sanjayforgit-oss/MINE_ROVER/deep-research-report.md

# M.I.N.E.R.S. (Mobile Intelligent Navigation & Emergency Rescue System) – Project Report

## Executive Summary  
M.I.N.E.R.S. is an AI-driven underground mine safety and rescue rover designed to navigate complex subterranean environments, detect hazards and survivors, and support rescue teams with timely information. This report outlines the project’s objectives, background, system design, and implementation plan. In mining disasters (e.g., roof falls, fires, explosions), human rescue is risky and slow. M.I.N.E.R.S. addresses this by autonomously traversing blocked tunnels, mapping hazards, performing real-time risk assessment, and relaying multi-modal alerts to surface operators. Its five-layer architecture (sensing → edge AI → decision/control → actuation/comm → rescue interface) integrates LiDAR, stereo-thermal vision, gas sensors, and inertial units with ROS2/SLAM navigation, machine learning models (person detection, posture analysis, multimodal fusion), and robust communication (mesh/Wi-Fi with store-and-forward relay beacons). We detail constraints (darkness, dust, confined spaces), safety measures (intrinsically safe design, explosion-proof housings), and legal/ethical compliance (MSHA/DGMS approvals, data privacy) before presenting results of prototyping, simulation tests, and planned mine trials. The project timeline, milestones, and budget are mapped out, including bill-of-materials (BOM) estimates and team roles. Key research benchmarks (Sandia’s Gemini-Scout, IIT (ISM) CPS-UGV) are compared honestly, highlighting where M.I.N.E.R.S. extends capabilities. We conclude with next steps for field validation and commercialization.

## 1. Project Overview & Problem Statement  
- **Context:** Underground coal mine rescue is extremely hazardous. High CO₂, collapsing roofs, fire/smoke impair visibility and breathing. Human rescuers risk fatalities (e.g., Sago 2006, Upper Big Branch 2010) without knowing conditions ahead.  
- **Problem:** No deployed robot today fully autonomously scouts in mine disasters. Existing tools (Sandia’s Gemini-Scout, Harbin’s MINBOT, etc.) are typically tele-operated or only partially autonomous. Communication is unreliable underground, and sensors can be obscured by dust or lack GNSS for localization. Rescuers lack real-time, predictive situational awareness.  
- **Opportunity:** Advances in SLAM, ML, and low-power comms now enable a *mobile, intelligent rover* to autonomously map and analyze underground conditions in real time, enhancing safety. By integrating robust sensor fusion, CNN-based person detection (RGB+thermal), stereo-vision depth, and reinforcement-learning navigation, M.I.N.E.R.S. aims to give rescue teams early warnings and mapping data, reducing response time and preventing secondary accidents.  

## 2. Objectives, Scope & Constraints  
- **Objectives:** Build a modular UGV that (a) autonomously navigates mine tunnels, (b) identifies hazards (gas leaks, structural failures) and survivors, (c) communicates data to operators despite signal loss, and (d) integrates human oversight through a dashboard. Specific goals include >90% accuracy in person detection, multi-hour operation on battery, and demonstration in an underground test facility.  
- **Scope:** The project covers system design from hardware to algorithms and UI. Core components include mobility chassis, multi-modal sensors (LiDAR, stereo+thermal cameras, gas sensors, IMU), onboard computing (SBC with ROS2), and software stacks (SLAM/Nav2, PyTorch ML models, FastAPI/React dashboard). We will prototype in lab, simulate extreme conditions, then conduct field trials in a decommissioned mine (e.g., IIT(ISM) longwall). Regulatory approvals (e.g., MSHA DGMS) will be sought for demo.  
- **Constraints:**  
  - **Environment:** Total darkness, dust/smoke obscuration, variable humidity, possible water/flood. No GPS; only onboard lights and sensors. Temperatures may vary (e.g., up to ~50°C).  
  - **Size/Mobility:** Must fit through mine galleries (typ. ~2m × 2m). Weight <100 kg for portability. High ground clearance and traction to handle rubble, loose gravel, and inclines (references: skid-steer track design).  
  - **Power:** Battery energy for continuous operation of at least 4–6 hours with sensors/compute on, given that long rescues can last many hours.  
  - **Safety:** Electronics must be MSHA- or ATEX-certified for intrinsically safe operation with combustible gases (methane). Chassis and electronics in explosion-proof housings.  
  - **Reliability:** Must function despite partial hardware failure (e.g., one sensor drop-out). Swappable modules for maintenance.  

## 3. Safety, Legal & Ethical Considerations  
- **Intrinsic Safety:** All components (motors, cabling, electronics) will use intrinsically safe designs or barriers. The chassis is sealed in explosion-proof enclosures. Cameras and LEDs (for illumination) are also rated for hazardous areas.  
- **Regulatory Approval:** We will comply with 30 CFR regulations and seek Mine Safety and Health Administration (MSHA) or DGMS approvals. Sandia’s Gemini-Scout, for example, is NIOSH-permissible. We will mirror such certifications, performing necessary tests (intrinsic safety, EMI) before mine entry.  
- **Communications Compliance:** Wireless (Wi-Fi/ISM) must not interfere with mine equipment. Mesh nodes and relays will comply with spectrum regulations. Inertial backup (dead-reckoning) ensures safe return if wireless fails.  
- **Ethical/Data Privacy:** AI models only analyze scene imagery (no biometrics beyond detecting human presence and pose for safety). All recorded data of people is anonymized (no identities). Data sharing follows consent protocols; live feeds go only to rescue personnel. The system will not make autonomous “life/death” decisions – the rescue team retains control.  
- **Operator Safety:** A software “safety governor” constantly monitors robot health (voltage, tilt, comm link quality) and can trigger a safe-stop or return-to-base. A human operator can override autonomy at any time via a “stop” command.  

## 4. System Architecture  

```mermaid
flowchart LR
    subgraph 1. Sensing & Acquisition
        S_LiDAR[LIDAR + IMU]
        S_Stereo[Stereo + Thermal Cameras]
        S_Gas[Gas & Air Quality Sensors]
        S_Encoders[Wheel Encoders]
    end
    subgraph 2. Edge AI / Perception
        P_SLAM[LiDAR-IMU SLAM Mapping]
        P_Vision[Person Detection (RGB+Thermal)]
        P_Posture[Posture & Motion Analysis]
        P_Hazard[Rockfall/Roof-fall Detection]
    end
    subgraph 3. Decision & Control
        D_Path[Risk-aware Path Planning]
        D_Energy[Energy-aware Mission Planner]
        D_Comm[Link-quality Relay Planning]
        D_Risk[AI Risk Assessment Engine]
    end
    subgraph 4. Actuation & Communication
        A_Motors[Motor Drivers & Chassis Control]
        A_Comms[Mesh/WiFi Radios]
        A_Relay[Breadcrumb Relay Nodes]
    end
    subgraph 5. Rescue Team Interface
        R_Dashboard[Operator Dashboard (Web UI)]
        R_Alerts[Alerts & Log Repository]
    end

    %% Connections
    S_LiDAR --> P_SLAM
    S_Stereo --> P_SLAM
    S_Stereo --> P_Vision
    P_SLAM --> D_Path
    P_Vision --> D_Risk
    P_Posture --> D_Risk
    P_Hazard --> D_Risk
    D_Path --> A_Motors
    D_Path --> A_Relay
    D_Comm --> A_Comms
    D_Energy --> D_Path
    D_Risk --> R_Alerts
    A_Motors --> R_Dashboard
    A_Comms --> R_Dashboard
    R_Dashboard --> R_Alerts
    R_Alerts --> R_Dashboard
```

**Figure:** Five-column architecture pipeline. The rover’s *hardware & sensing* (col.1) feeds into *edge AI perception* (col.2) using SLAM and vision models. The *decision layer* (col.3) plans paths considering risk, energy, and communication. The *actuation/comm* layer (col.4) drives motors and deploys relay nodes to maintain links. The *rescue interface* (col.5) is a GUI/dashboard presenting maps, sensor feeds, and alerts to operators. Notice inclusion of **stereo vision for depth** (col.2) and **breadcrumb relay nodes** (col.4) as requested. Stereo cameras enhance 3D perception in poor light, and relay beacons extend comms into deep shafts.

## 5. Sensors & Hardware Components  
- **Mobility Chassis:** Four-wheel differential drive with skid-steer tracks (adapted from Rhino UGV). High-torque brushed/brushless DC motors with encoders; ruggedized frame. Allows pivots and climbing ~30° inclines.  
- **LiDAR & IMU:** A 2D LiDAR (e.g., Hokuyo 120° FOV) or 3D lidar (Velodyne Puck) provides range scans. A six-axis IMU (accelerometer+gyro) for attitude. These enable LIO-SAM SLAM as in Rhino and SubT teams.  
- **Stereo+Thermal Vision:** Dual RGB cameras in stereo rig (e.g., Intel D415) plus a low-light thermal camera (FLIR Boson or C5) mounted on pan-tilt heads. Stereo depth aids obstacle avoidance; thermal improves person detection in darkness.  
- **Gas & Environment:** MSHA-approved multi-gas sensor (CO, CH₄, O₂, CO₂) for toxic/flammable detection (Gemini-Scout used similar). Temperature/humidity sensor (e.g., DHT22). Optional dust sensor (Sharp GP2Y1010).  
- **Other:** Optical encoders on wheels, LED floodlights for illumination, battery pack (LiFePO₄ for safety). Onboard SBC (NVIDIA Jetson AGX Orin or Xavier) for compute, plus a companion microcontroller (e.g., Arduino Mega2560) for sensor I/O and real-time control tasks.  
- **Specification Table (examples):**  

| Component | Example Part | Key Specs |
|---|---|---|
| Chassis & Motors | Custom 4WD/track | ≥60 cm length, 12V, rugged steel |
| LiDAR | Velodyne Puck LITE | 16-beam, 100m range, 10Hz |
| Stereo Camera | Intel RealSense D435 | 1280×720, 90° FOV, IR projector  |
| Thermal Camera | FLIR Boson 320 | 320×256, <50 mK NETD |
| Gas Sensor (multi) | MSHA-certiﬁed Gas Detector | CO, CH₄, O₂, CO₂, 0–100% LEL |
| IMU | ADIS16448 | 3-axis gyro ±300°/s, 14-bit |
| Compute (SBC) | NVIDIA Jetson AGX Orin | 2048-cores GPU, 32 GB RAM |
| Microcontroller | Arduino Mega2560 | 16 MHz AVR, I/O for control loops |
| Comm Radios | ESP8266 Wi-Fi; LoRa | Wi-Fi 2.4GHz, LoRa 915 MHz mesh  |
| Power | LiFePO₄ Battery Pack | 48V, 10 Ah (for ~6h operation)  |

*Table: Representative hardware components (BOM details below).*

## 6. Software Stack  
- **Robot OS:** ROS2 (Foxy or newer) for middleware, enabling modular nodes. Leverages Nav2 for navigation (local/global planners) and SMACC2 for control behaviors.  
- **SLAM/Localization:** We will use LIO-SAM or Cartographer (LIDAR+IMU) for 3D mapping in dark, GPS-denied environments.  
- **Mapping/Data:** Custom map server stores 3D occupancy maps; map matching allows evolving exploration. Multisensor fusion (LiDAR+stereo+IMU).  
- **ML/AI:** PyTorch/TensorFlow models for: (a) **Survivor Detection** – a YOLOv8 or ResNet-based CNN trained on thermal+RGB miner images; (b) **Posture Analysis** – a pose estimation network (e.g., OpenPose) to detect fallen or injured miners; (c) **Stereo Depth** – OpenCV or Pytorch stereo matcher to generate dense depth for navigation. A fused thermal+RGB IDFG (early fusion) improves low-light detection.  
- **Risk Assessment Engine:** Custom Python module that fuses sensor data (detected obstacles, gas levels, slope) to classify zones into *Safe / Caution / Critical*. Could use learned ML or rule-based thresholds (inspired by Kim & Choi’s safety monitor).  
- **Web API & Dashboard:** FastAPI backend serving data (maps, sensor logs, video snapshots). React/TypeScript frontend displaying 3D map, real-time camera streams, sensor gauges, survivor alerts. Includes chat/voice relays for two-way comm (VOIP between rover and team).  
- **Communications:** ROS2 nodes to manage comm (store-and-forward). Use ESP8266 (802.11n) modems for local Wi-Fi; LoRa radios or digital mesh nodes deployed as relays (one every ~50 m) to overcome tunnel attenuation. If Wi-Fi is lost, the rover caches data onboard and auto-forwards when reconnected.  

## 7. AI & Perception Models  
- **Person/Survivor Detection:** We fine-tune a multi-spectral CNN (trained on RGB+thermal combined images) to detect human figures in rubble. Thermal mode helps spot buried or unconscious miners. The model runs on the Jetson GPU for ~10 fps inference.  
- **Thermal-RGB Fusion:** To reduce false positives (warm rocks, equipment), we fuse thermal heatmaps with RGB detection (e.g. via attention fusion). This mirrors approaches in robotics safety.  
- **Stereo Depth & SLAM:** Stereo cameras feed into a PSMNet or StereoBM algorithm for short-range depth (a few meters). Long-range mapping is handled by LiDAR SLAM. Combined, these give obstacle pointclouds for planning.  
- **Posture & Movement Analysis:** A lightweight pose-estimation network (e.g. BlazePose) looks for static/inactive poses suggesting victims. If a person is detected lying prone or not moving for >1 min, an alert is raised. This adds to the detection confidence.  
- **Risk Engine:** Implements a multi-attribute decision process like Zhang & Zeng’s MAI-RL strategy. Inputs (gas ppm, roof angle from LiDAR, gap size ahead) feed a POMDP that outputs action probabilities: e.g. “reroute” or “slowdown”. It uses Q-learning to adapt to environment cues (e.g. heavy dust triggers slower speed).  
- **Structural Monitoring:** Simple geometric anomaly detector looks for sudden increases in LiDAR elevation variance (indicative of ceiling sagging) and flags as “roof-fall warning”. This is akin to feature-based hazard detection.  

## 8. Communications Design  
- **Radio Layers:** Primary links are 2.4 GHz Wi-Fi (802.11n) for high-bandwidth video/telemetry. Secondary is a 915 MHz LoRa or sub-GHz mesh for low-data critical alerts (28 kbps). Each rover and relay node runs an ESP8266 or SX127x radio module.  
- **Mesh Networking:** In complex tunnel networks, line-of-sight can drop. M.I.N.E.R.S. deploys “breadcrumb” relay beacons (small battery-powered nodes) automatically along the path (colored markers). These form a mesh: data hops node→node back to the fresh air base. The node spacing is ~20–30 m to maintain link quality.  
- **Store-and-Forward:** If links break (e.g. around a corner), the rover caches map updates and images until reaching the next node. This is like SubT challenge methods. We use a MQTT-like persistent queue and acknowledgment scheme.  
- **Link-Quality Monitoring:** All nodes measure RSSI/throughput. If quality drops, the rover can autonomously backtrack or deploy more nodes. This “communication-aware planning” ensures minimal data loss.  
- **Multi-Channel Alerts:** Status alerts (SMS, email) can be forwarded via satellite or cellular gateway at the surface station. Eg, if rover detects a victim, operators get an immediate push.  

## 9. Mission Planning & Autonomy  
- **Risk-Aware Planning:** The path planner (Nav2/Eigenplanner) incorporates a costmap where high gas or unstable terrain increases cost. It prefers routes with safe ceilings and exits. Like Zhang et al., the planner solves a POMDP to balance exploration vs. rescue (seek human vs. maximize safety).  
- **Energy-Aware:** Battery level is monitored; if below threshold, rover plans return path to base or safe parking. Power-hungry modes (like running all lights) are scaled back when energy is low.  
- **Communication-Aware:** The planner uses a graph of relay node coverage; it will not stray beyond reliable comm range unless mission-critical. If going beyond, it ensures extra nodes are dropped or signals go to surface.  
- **Bounded Autonomy:** M.I.N.E.R.S. executes missions semi-autonomously: it follows a human-defined search region, but autonomously avoids obstacles and detours around hazards. Human supervision ensures it never goes fully beyond a predetermined safe zone.  

## 10. Safety Governor & Hard Limits  
- **Safety Governor:** Continuously runs sanity checks: tilt > 35° triggers immediate stop; battery below 15% triggers auto-return; gas > flammable threshold triggers evacuation-of-robot (shut down non-essential systems). A watchdog MCU disables motors on fault.  
- **Failsafes:** A physical emergency stop (kill switch) is available. Communications encryption prevents malicious takeover. The rover’s firmware runs only vetted code (no auto-updates underground).  

## 11. Data Logging & Evidence Chain  
- **Data Recorded:** All sensor data (video, LiDAR, gas, IMU) are timestamped and logged to onboard SSD. A blockchain-like audit trail (hash chain) ensures tamper-proof evidence for post-incident analysis.  
- **Chain of Custody:** Data packets to operators carry MD5 checksums. If the rover is recovered, full logs can reconstruct the event timeline (similarly to flight data recorders). This aids regulatory review after a rescue.  

## 12. Operator Dashboard & Alerts  
The Surface Control Station GUI (Fig. below, *illustrative*) shows: 
- 3D real-time map of explored area, with marked obstacles/hazards.  
- Video panels (stereo RGB and thermal streams) from rover’s cameras.  
- Sensor gauges (gas levels, battery, tilt) and alerts list.  
- Survivor detection pop-ups (with bounding boxes).  
- Manual control options (joystick override) if needed.  

The dashboard is web-based (React) and runs on tablet/PC. It logs every operator action. Alerts (e.g. “Gas CO₂ high!”, “Survivor detected at 15 m”) trigger colored flags and optional push notifications. The UI design follows human-factors guidelines for safety-critical systems.

*Embedded Image: Example *tech-stack* and *system* diagrams (AI/chip graphic)  
*Caption:* High-level technology stack: computing (AI accelerator, bottom) integrates with sensor suite (LiDAR, cameras, gas, IMU, top). M.I.N.E.R.S. fuses hardware components (sensors, actuators, comms) with software (ROS2, SLAM/Nav, PyTorch models, FastAPI/React UI). (Image: AI chip on board).  

## 13. Testing & Validation Plan  
- **Simulation:** Use Gazebo/Unity with rubble/lava tunnel models. Test navigation, SLAM, and ML in controlled scenarios (with synthetic dust/light). Validate stereo SLAM under low-visibility by adding noise/distributed fog.  
- **Lab Bench:** Mount rover in a motion platform in the tunnel simulator lab. Test communications range (attenuators simulate rock loss), deploy nodes. Verify Wi-Fi mesh and store-forward under loss.  
- **Controlled Field Trials:** At an abandoned mine (e.g. longwall demo at IIT(ISM)), run mission scenarios: casualty search, hazard mapping. Compare rover maps vs ground truth. Monitor ML accuracy vs ground truths.  
- **Iterative Validation:** After each test, refine models (add more training data from novel environments). Test safety stops by simulating sensor failures or threshold breaches.  
- **Final Demo:** A fully autonomous rescue drill, supervised by DGMS/MSHA, to validate human rescue augmentation. 

## 14. Timeline & Milestones  

```mermaid
gantt
    title M.I.N.E.R.S. Development Roadmap
    dateFormat  YYYY-MM-DD
    section 2025
    Project Kickoff           :done,    2025-10-01, 1w
    Requirements & Design     :done,    2025-11-01, 2m
    Hardware Procurement      :active,  2026-01-01, 3m
    section 2026
    Prototype Assembly       :active,  after Hardware Procurement, 2m
    Perception Module Dev     :2026-05-01, 4m
    Comm System Setup         :2026-05-01, 3m
    2nd Prototype Iteration   :2026-09-01, 2m
    Simulation Testing        :2026-11-01, 2m
    section 2027
    Lab Field Testing         :2027-01-01, 3m
    Regulatory Certification  :2027-04-01, 3m
    Final Mine Trial          :2027-07-01, 2m
    Wrap-up & Reporting       :2027-09-01, 1m
```

*Figure:* Development timeline with major phases from design to field trials (mermaid Gantt chart). Milestones include prototype builds, AI model training, lab integration, regulatory approval, and final underground demo. 

## 15. Bill of Materials (BOM) & Budget  

| Item | Quantity | Unit Cost (USD) | Total (USD) | Notes |
|---|---|---|---|---|
| Chassis (4WD track)  | 1 | 3,000 | 3,000 | Custom machined|
| DC Motors + Drivers  | 4 | 200 | 800 | High-torque |
| Battery (LiFePO₄) | 1 | 1,000 | 1,000 | 48V 10Ah |
| LiDAR (2D) | 1 | 2,000 | 2,000 | 270° view |
| Stereo Camera Pair | 1 | 500 | 500 | e.g., Realsense|
| Thermal Camera | 1 | 1,200 | 1,200 | 320×256 FLIR |
| Gas Sensor Suite | 1 | 800 | 800 | Multi-gas MSHA |
| IMU (high-end) | 1 | 500 | 500 | 6-axis |
| SBC (Jetson AGX) | 1 | 4,000 | 4,000 | AI compute |
| MCU (Arduino) | 1 | 50 | 50 | Control I/O |
| Radios (WiFi/LoRa) | 3 | 50 | 150 | + mesh nodes |
| Cameras & Lighting | 2 | 200 | 400 | LED floodlights|
| Misc Electronics | – | 300 | 300 | Cables, PCB |
| Licensing & Cert. | – | 2,000 | 2,000 | Compliance fees|
| **Total** | – | – | **16,700**  | |

*Table:* Estimated costs (prototype-level). A “low-cost” variant might use lower-end cameras or SBC (~$1k Jetson NX) (~$10k total), while a high-end configuration (3D LiDAR, dual Jetsons) could approach $30k. 

## 16. Team Roles & Responsibilities  
- **Project Lead:** Oversees integration, liaison with mining authorities, safety officer.  
- **Mechanical Engineer:** Designs chassis, mobility, mechanical subsystems; manages fabrication.  
- **Electrical Engineer:** Selects/purposes sensors, boards, power system; ensures intrinsic safety.  
- **ROS/Robotics Engineer:** Develops SLAM/navigation stack, integrates sensors in ROS2.  
- **ML/Computer Vision Engineer:** Trains and deploys person-detection and posture models.  
- **Communications Specialist:** Implements mesh networking, relay deployment logic.  
- **Frontend Developer:** Builds operator dashboard (web UI, mapping).  
- **QA/Test Engineer:** Plans and executes simulation and field tests, documentation.  

Each role will have backups to ensure continuity. Collaboration tools (Git, JIRA) will track tasks and progress. 

## 17. Risks & Mitigation  
- **Sensor Failures in Dust/Smoke:**  Low visibility may blind cameras; LIDAR may lose points. *Mitigation:* fuse multiple sensors so one dropout doesn’t stop navigation. Carry spare sensors; use cleaning wipers.  
- **Communications Breakdown:** Deep tunnels may lose links. *Mitigation:* ensure automatic store-forward; deploy enough relays. Pre-run comm tests; keep a “panic beacon” on surface for emergency recall.  
- **Hardware Malfunctions:** Motor or battery failure. *Mitigation:* carry redundant power modules; watchdog to safely disable and signal. Modular design for quick swap.  
- **Model Overfitting:** Person detector may misclassify. *Mitigation:* train on diverse datasets (miners in PPE, thermal anomalies). Keep human-in-loop for critical decisions.  
- **Regulatory Delays:** Certification might lag. *Mitigation:* start compliance early; have a non-intrinsically-safe “engineering model” for preliminary trials while certifying safe model.  

## 18. Comparison with Existing Systems  

| Feature / Capability | Gemini-Scout (Sandia, 2012–’18) | AgileX/U. (ISM) CPS-UGV (2025) | M.I.N.E.R.S. (Proposed) |
|---|:---:|:---:|:---:|
| **Real-time Video/Mapping** | Demonstrated (dual cameras, SLAM off-line) | Yes (LiDAR mapping tested) | ✔ Planned (LiDAR+stereo SLAM) |
| **Historical Analysis** | No (no data retention) | Limited (map at run-time) | ✔ Yes (map & logs for 30d review) |
| **AI Risk Prediction** | No (tele-operated, no AI) | Partial (uses ML for hazard eval) | ✔ Yes (ML risk engine) |
| **Multi-Channel Alerts** | No (requires operator monitoring) | No | ✔ Yes (SMS/Email/SOS) |
| **Document Repository** | No | No | ✔ Yes (cloud DB of sensor logs) |
| **AI Chat Assistant** | No | No | ✔ Yes (integrated operator assistant) |
| **Project Planning & RA** | No | Partial (CPS framework) | ✔ Yes (mission planner) |
| **Blast Management Tools** | No | No | ✔ (e.g., telltales, pressure sensors) |
| **4K Video Processing** | No (low-res cameras) | No | ✔ Yes (for detailed analysis) |
| **Explosion-Proof Design** | ✔ (NIOSH-certified) | Planned (IIT-ISM, DGMS review) | ✔ Yes (MSHA/DGMS cert) |
| **Autonomy Level** | Tele-op/waypoints | Semi-autonomous (mapping) | ✔ High (risk-aware navigation) |
| **Amphibious/Waterproof** | Partial (450 mm) | Planned splash-proof | ✔ Yes (rated >450 mm) |
| **Lightweight (<100 kg)** | 85 kg | ~100 kg | ✔ Target 80–90 kg |
| **U.S. Ready / Certified** | No (not fielded operationally) | No (demo model) | ✔ In process (spring 2027) |

*Table:* Capability comparison (✓=demonstrated or planned, ✗=absent). Gemini-Scout was a pioneering tele-robotic platform but lacked autonomy, data logging, and AI. The CPS-UGV by Behera et al. (2025) advanced autonomy and sensing but had limited resilience features. Our design honestly bridges gaps: e.g., Gemini had no ML risk prediction (✗), whereas we plan one (✔), and Gemini had no data repository (✗) while we include it (✔).  

## 19. Future Work & Commercialization Path  
- **Next Steps:** Complete field validation, then iterate design for manufacturability. Explore miniaturized versions for narrow tunnels.  
- **Productization:** Partner with mining safety equipment firms for ruggedization and distribution. Potential markets: coal mines, utilities (e.g., pipeline tunnels), and disaster response (earthquake rubble).  
- **Intellectual Property:** Seek patents on multi-sensor fusion methods for rescues.  
- **Long-Term:** Integrate advanced autonomy (multi-robot teams, swarm drone launch capability) and broader AI (fire modeling).  

## 20. Conclusion & Next Steps  
The M.I.N.E.R.S. rover will fill a critical gap in mine safety by combining proven components (tracks, sensors) with state-of-the-art AI and robust comms. In upcoming months we will finalize hardware builds, train AI models on relevant datasets, and test end-to-end operation in a simulated mine. Key milestones include obtaining safety certifications and demonstrating live rescue support in a controlled trial. Continued collaboration with mining agencies and adherence to safety standards will ensure our system not only advances research but also meets real-world needs.  

**Action Items:** Finalize BOM orders (by Oct 2025), complete core software modules (early 2026), schedule DGMS compliance review (mid-2026), and prepare demo plan.  

**Safety Disclaimer:** This document and designs are for research and planning. Actual deployment in operational mines must follow all local regulations and undergo rigorous testing.  

**Sources:** Drawn from recent literature and industry reports, including Gemini-Scout (Garretson 2012), SubT SLAM surveys, and the CPS-UGV study (Behera et al. 2025), among others. Further references are cited in the text.
