sanjayforgit-oss/MINE_ROVER/miners_architecture_human.pptx

SYSTEM ARCHITECTURE & TECHNICAL FLOW
M.I.N.E.R.S. — Mobile Intelligent Navigation and Emergency Rescue System | SIH 2026 (PS ID: 26039)

01. MULTI-MODAL SENSING
Environmental & Spatial Perception
• 360° 2D LiDAR: Continuous 2D tunnel mapping & boundary obstacle detection (No 3D LiDAR).
• Stereo RGB-D Camera: Unified camera for visual video stream & dense depth traversability.
• Thermal IR Camera: Detects survivor body heat signatures through darkness, dust and smoke.
• Multi-Gas Sensor Array: Real-time toxic & flammable gas tracking (CH4, CO, CO2, O2, Smoke).
• Slip-Aware IMU & Encoders: 6-DOF IMU and wheel encoders provide dead reckoning in zero-GPS tunnels.

02. INTELLIGENT EDGE BRAIN
Onboard AI & Distributed Compute
• Raspberry Pi 5 (8GB): Master edge host orchestrating ROS2 nodes, communication & sensor fusion.
• Raspberry Pi AI HAT+: 26 TOPS NPU delivers real-time on-device YOLOv8 person & posture inference.
• Arduino Mega 2560: Hard real-time deterministic motor PWM actuation & hardware safety watchdog.
• Isolated Power Unit: Dedicated 12V high-current motor rails & clean 5V logic rails with BMS telemetry.

03. BOUNDED AUTONOMY & SAFETY
Resilient Decision & Fail-Safe Navigation
• Safety Governor: Hard constraint rules strictly override AI to enforce emergency stops & safe retreat.
• Bounded Autonomy: Operates under strict distance & time limits during complete communication loss.
• Safe Auto-Rollback: Backtracks along proven safe path upon sudden gas spikes or structural cracks.
• Breadcrumb Mesh Relays: Drops deployable wireless repeater nodes to maintain connectivity deep inside.
• Blackbox SD Buffer: Store-and-forward local logging guarantees zero mission data is ever lost.

SURFACE RESCUE COMMAND STATION (Human-in-the-Loop Base)
🗺️ Real-Time 2D Grid & Gas Heatmap | 📹 Video + Thermal IR Stream | 📡 Mesh Relay Telemetry | 🕹️ Manual Emergency Override (E-STOP)
Guiding Principle: “AI Assists Detection — Rescue Team Makes the Final Decision” | Bounded Autonomy During Signal Blackout
