sanjayforgit-oss/MINE_ROVER/link_plate_120x8mm_preview.png

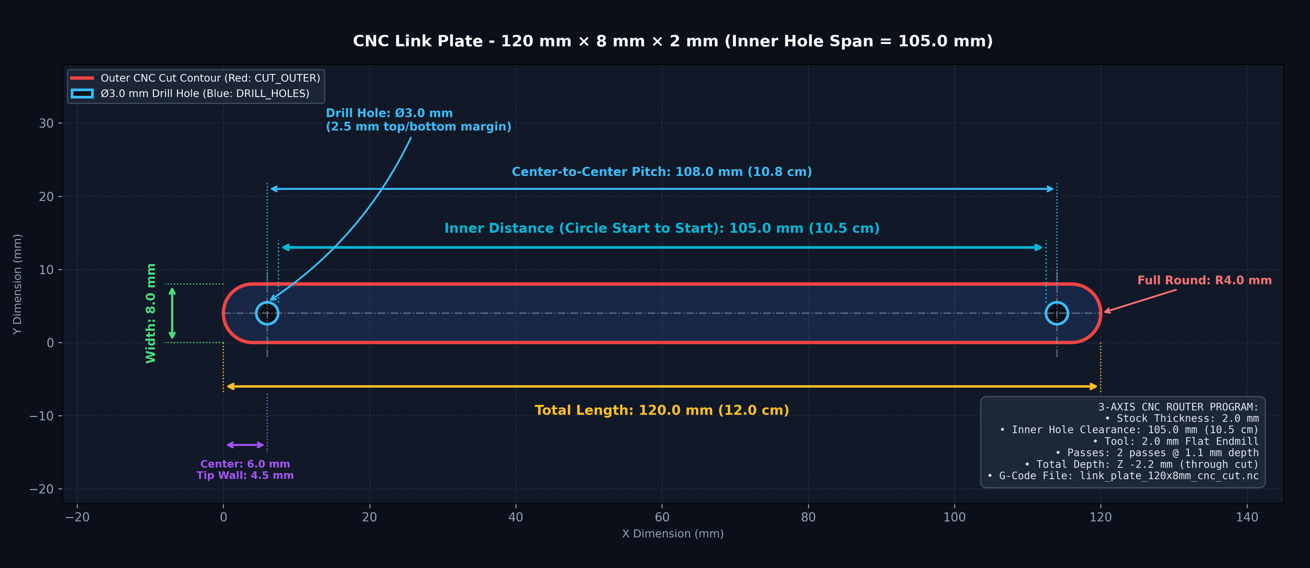
link_plate_120x8mm_preview.png
