sanjayforgit-oss/MINE_ROVER/rover_base_alternative_designs.png

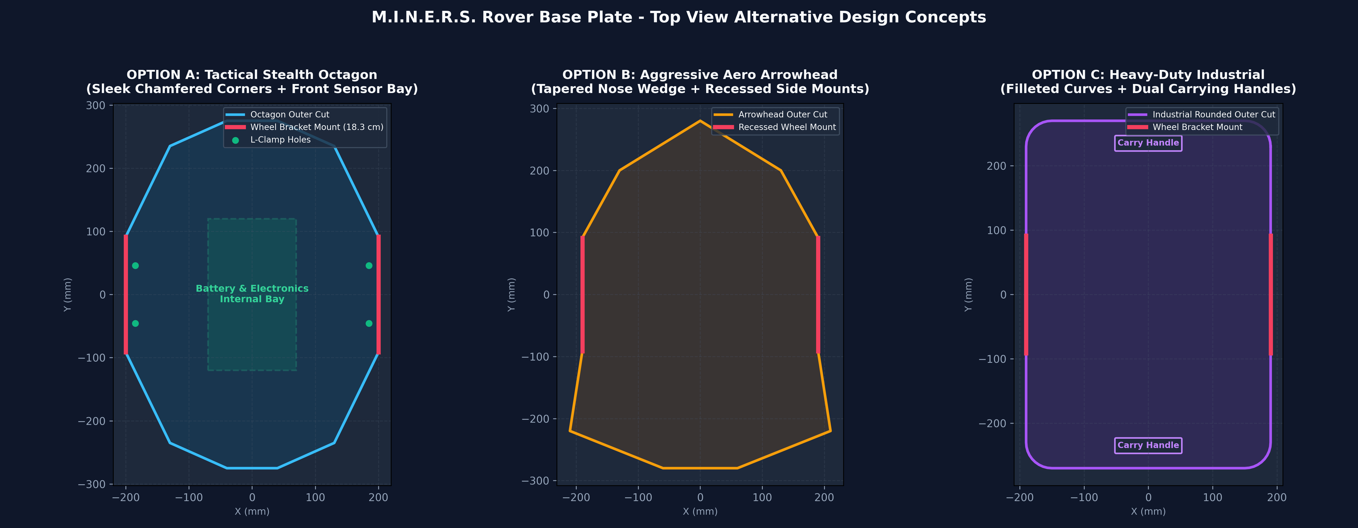
rover_base_alternative_designs.png
