sanjayforgit-oss/MINE_ROVER/rover_base_preview.png

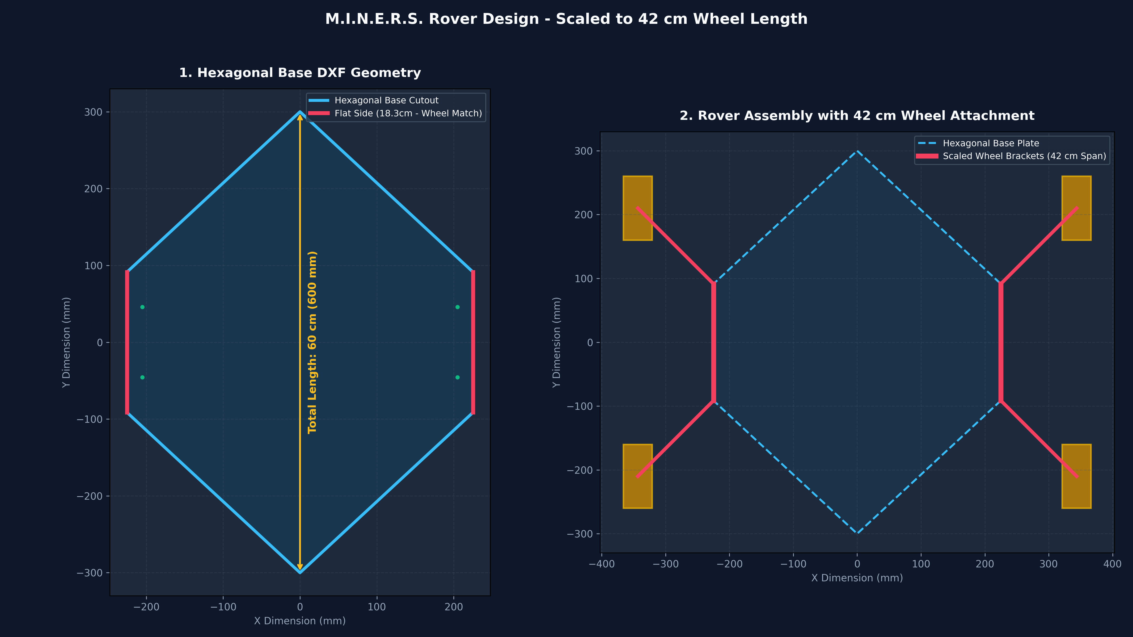
rover_base_preview.png
