sanjayforgit-oss/MINE_ROVER/simulation_video_preview.png

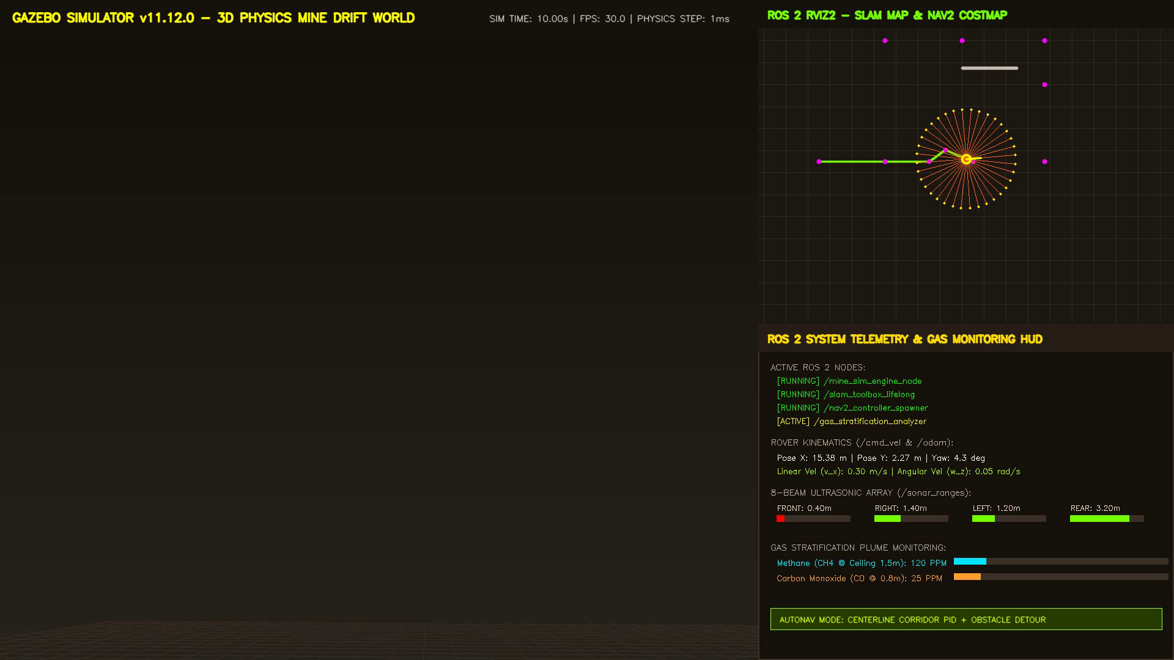
simulation_video_preview.png
