sanjayforgit-oss/MINE_ROVER/wheel_attachment_bracket_preview.png

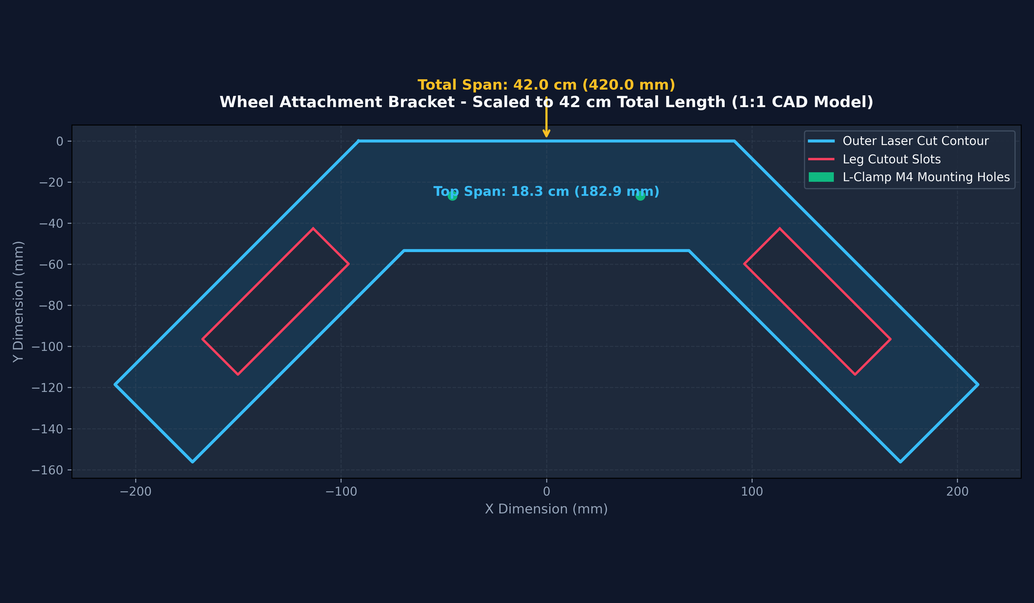
wheel_attachment_bracket_preview.png
