sanjayforgit-oss/MINE_ROVER/wheel_base_support_crossbar_preview.png

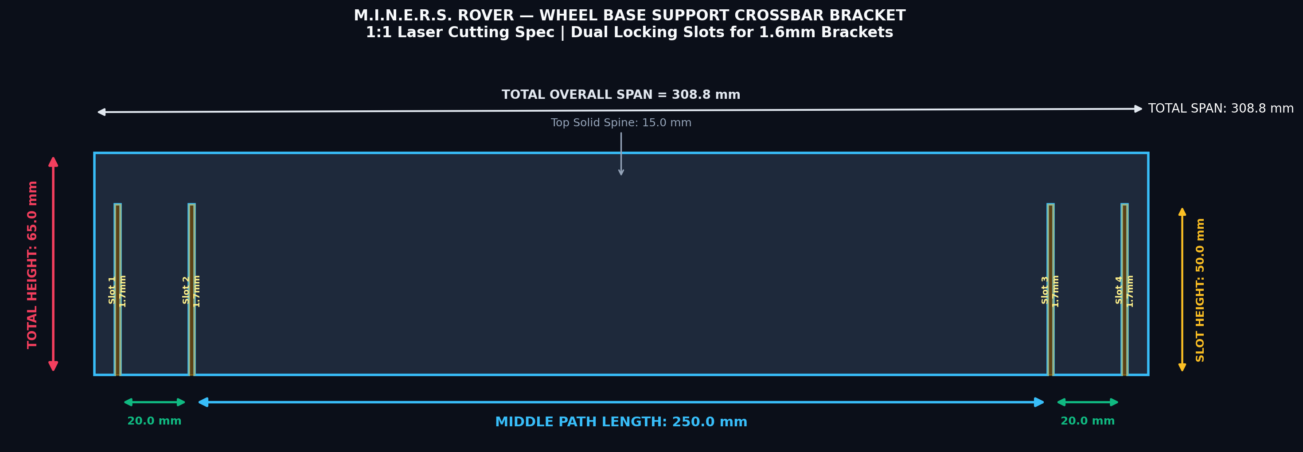
wheel_base_support_crossbar_preview.png
