sanjayforgit-oss/MINE_ROVER/wheel_bracket_spacer_clip_preview.png

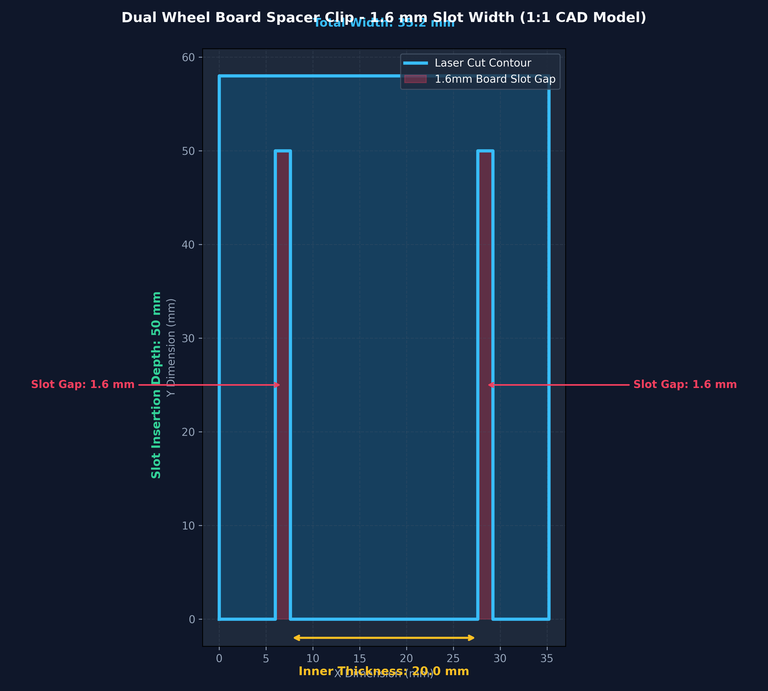
wheel_bracket_spacer_clip_preview.png
