sanjayforgit-oss/MINE_ROVER/component list of minerover.xlsx

Components list for MINEROVER |  |  |  |  |  |  | PDF item | Qty in your inventory | MINE-SENTINEL use
S.NO | NAME | count | 1pcs PRICE | total price | LINK | estimate | Arduino Mega 2560 16U2 clone | 10 | Low-level controller/safety I/O
1 | Raspberry pi 5 with 8gb ram | 1 | 23500 | 23500 | https://amzn.in/d/09Gowpl9 |  | SanDisk Ultra 32 GB microSD | 5 | Initial Pi storage
2 | Raspberry Pi AI HAT+ 26 TOPS | 1 | 15250 | 15250 | https://amzn.in/d/0adwNgWo |  | 12 V 150 RPM gear motor | 20 | 4WD prototype
3 | raspberry pi cooling fan | 1 | 1050 | 1050 | https://amzn.in/d/077CWEg8 |  | NodeMCU ESP8266 | 6 | Prototype communication/relay
4 | 360 degree 2d lidar | 1 | 6300 | 6300 | https://robu.in/product/ydlidar-x2l-range-finder/?gad_source=1&gad_campaignid=20363337560 |  | DHT-11 | 1940-10-01 | Initial temperature/humidity
5 | Waveshare IMX219-83 Stereo Camera | 1 | 6400 | 6400 | https://robu.in/product/waveshare-imx219-83-stereo-camera-8mp-binocular-camera-module-depth-vision/ |  | MQ-4 | 3 | Prototype methane-sensitive channel
6 | ASAIR AO-03 Oxygen Sensor Module | 1 | 1219 | 1219 | https://robu.in/product/oxygen-sensor-model-ao-03/ |  | MQ-7 | 3 | Prototype CO-sensitive channel
7 | Robocraze GP2Y1010AU0F Optical Dust Sensor | 1 | 660 | 660 | https://amzn.in/d/0bnvKIct |  | Ultrasonic SR04 | 40 | Close-range obstacle safety
8 | MAX9814 microphone module | 1 | 367 | 367 | https://amzn.in/d/03cLVMzK |  | Joystick module | 10 | Manual control mode
9 | 2pcs BTS7960 43A High Power Motor Driver | 2 | 1080 | 2160 | https://amzn.in/d/0hfzQLRg |  | Relay boards | 20 | Low-current auxiliary switching
10 | wheel encoder LM393 Optical Coupling Module pack of 5 | 1 | 299 | 299 | https://amzn.in/d/0b53gtjS |  | MG996/MG90/MG995 servos | 30 total variants | Camera/sensor actuation
11 | 20-sot encoder dics | 1 | 499 | 499 | https://amzn.in/d/05nODV82 |  | Jumper wires | Many | Prototype
12 | IMU (MPU6050 6- axis gyroscope and accelerometer | 1 | 319 | 319 | https://amzn.in/d/096DA06l |  | Hookup wire | Available | Prototype
13 | 12.8V 30Ah (384Wh) LiFePO4 | 1 | 7869 | 7869 | https://amzn.in/d/0eaNqDHC | 9000 | 0–30 V / 5 A bench supply | 1 | Laboratory development
14 | battery charger | 1 | 1449 | 1449 | https://amzn.in/d/05J6uaGG |  | Oscilloscope | 1 | Testing
15 | dc-dc buck converter | 1 | 587 | 587 | https://amzn.in/d/02MxcZ3Q |  | Soldering station | 2 | Assembly
16 | dc-dc step dpwn for raspberry | 1 | 490 | 490 | https://amzn.in/d/05kZcI8O
17 | dc-dc atep down for esp, mega | 1 | 494 | 494 | https://amzn.in/d/01jdCEdt
18 | fuse holder | 1 | 292 | 292 | https://amzn.in/d/0hhNiHZU
19 | main battery switch 12v - 24v | 1 | 399 | 399 | https://amzn.in/d/06YptNCs
20 | 12v , 80A automative relay | 1 | 199 | 199 | https://amzn.in/d/0ffsDL9Q
21 | power distributor | 1 | diy | 0
22 | xt60 connector pins | 1 | 155 | 155 | https://amzn.in/d/0gwMlcKR
23 | terminal lock/ferules |  | 0 | 0
24 | push button switch | 1 | 280 | 280 | https://amzn.in/d/0cO8GgRb
25 | INA219 - BATTERY POWER SENSOR | 1 | 209 | 209 | https://amzn.in/d/0hpKUrba
26 | main batter current sensor module | 1 | 672 | 672 | https://amzn.in/d/0aK1Whwd | cheaper here - https://thinkrobotics.com/products/acs758?variant=49842274369853&country=IN&currency=INR
27 | pan/tilt servo bracker, for camera moving | 1 | 240 | 240 | https://amzn.in/d/0i13CrOu
28 | water level sensor | 1 | 57 | 57 | https://amzn.in/d/0bLffNhl
29 | strip light(pack of 20)- used as head lights | 1 | 293 | 293 | https://amzn.in/d/014DVYJ4
30
 |  |  | TOTAL | 71708
