sanjayforgit-oss/MINE_ROVER/wheel_attachment_bracket.dxf

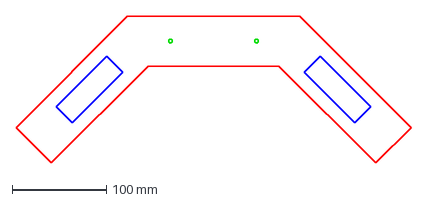
[picture p8: CAD file, 2026-10-26]
wheel_attachment_bracket.dxf
420.0 x 156.3 mm
