sanjayforgit-oss/MINE_ROVER/wheel_bracket_spacer_clip.dxf

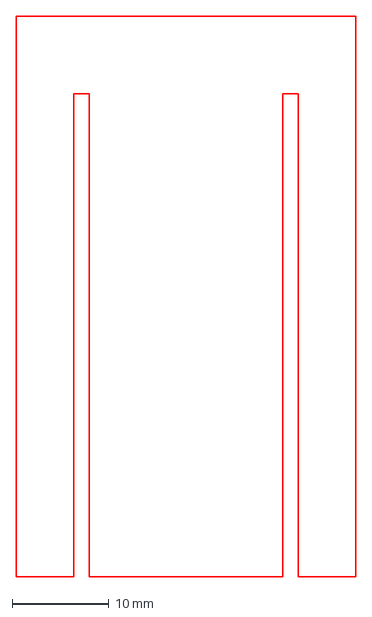
[picture p9: CAD file, 2026-10-26]
wheel_bracket_spacer_clip.dxf
35.2 x 58.0 mm
