sanjayforgit-oss/MINE_ROVER/link_plate_120x8mm_offset8mm.dxf

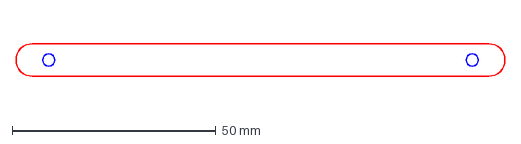
[picture p11: CAD file, 2026-10-26]
link_plate_120x8mm_offset8mm.dxf
120.0 x 8.00 mm
