sanjayforgit-oss/MINE_ROVER/wheel_base_support_crossbar.dxf

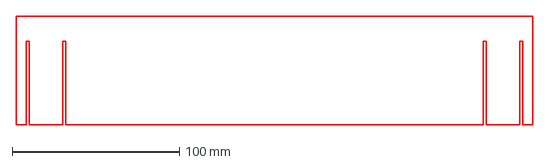
[picture p12: CAD file, 2026-10-26]
wheel_base_support_crossbar.dxf
308.8 x 65.0 mm
