sanjayforgit-oss/MINE_ROVER/sample_mine_drift_blueprint.dxf

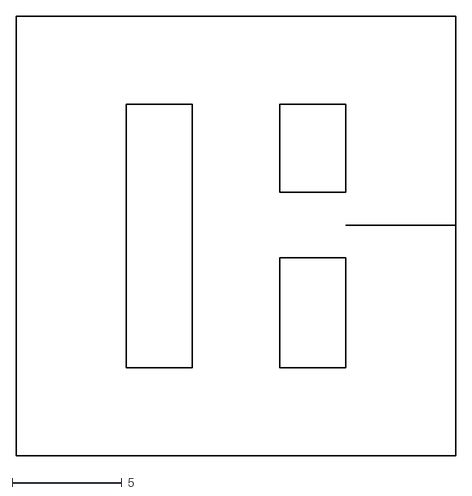
[picture p13: CAD file, 2026-10-26]
sample_mine_drift_blueprint.dxf
20.0 x 20.0
