sanjayforgit-oss/MINE_ROVER/rover_base_hexagon.dxf

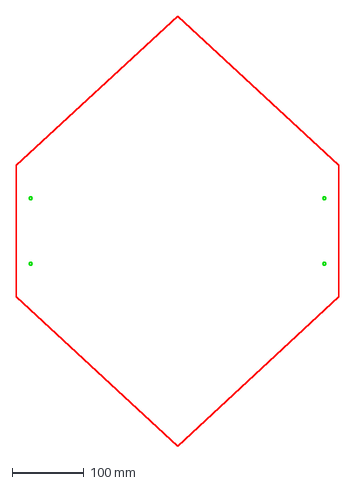
[picture p14: CAD file, 2026-10-26]
rover_base_hexagon.dxf
450.0 x 600.0 mm
