sanjayforgit-oss/MINE_ROVER/rover_base_stealth_octagon.dxf

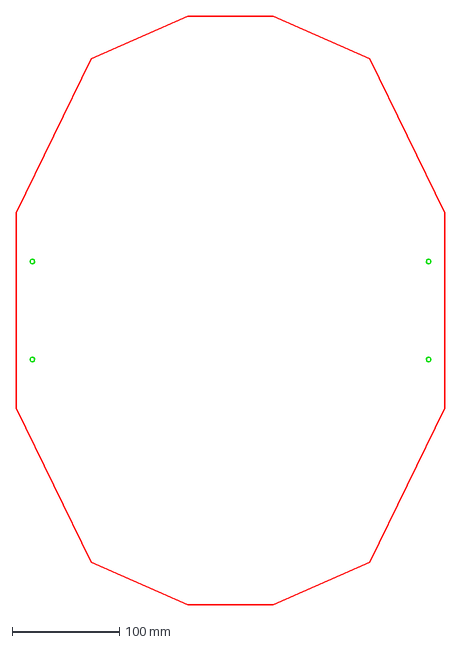
[picture p15: CAD file, 2026-10-26]
rover_base_stealth_octagon.dxf
400.0 x 550.0 mm
