sanjayforgit-oss/MINE_ROVER/link_plate_120x8mm_R12.dxf

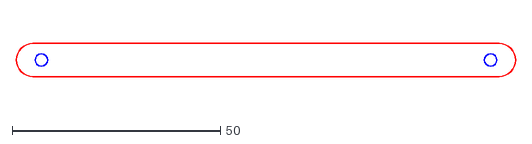
[picture p16: CAD file, 2026-10-26]
link_plate_120x8mm_R12.dxf
120.0 x 8.00
