sanjayforgit-oss/MINE_ROVER/link_plate_120x8mm.dxf

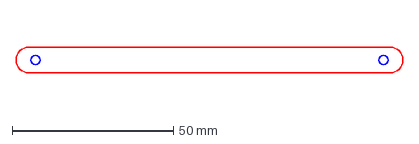
[picture p17: CAD file, 2026-10-26]
link_plate_120x8mm.dxf
120.0 x 8.00 mm
