sanjayforgit-oss/MINE_ROVER/miners_architecture_manual.pptx

M.I.N.E.R.S. SYSTEM ARCHITECTURE
Mobile Intelligent Navigation and Emergency Rescue System | SIH 2026 (PS ID: 26039)

1. SENSE
Multi-Modal Sensors

1. SENSING LAYER
“Sense the Mine”

• 360° 2D LiDAR
2D Tunnel Contour & Obstacle Boundary

• Stereo RGB-D Camera
Dense Depth Estimation & Video Feed

• Thermal Camera
Infrared Heat Signature & Survivor Spot

• Multi-Gas Sensor Array
CH4, CO, CO2, O2, Flammable/Toxic Gases

• Environmental Sensors
Temperature, Humidity, Airflow, Dust

• Ultrasonic Array
Blind-Spot & Water Puddle Redundancy

• IMU + Wheel Encoders
Dead Reckoning & Odometry Tracking

2. COMPUTE
Edge Processing

2. EDGE COMPUTE
“Process Locally”

• Raspberry Pi 5 (8GB)
System Orchestration, ROS2 Core, Logging

• Raspberry Pi AI HAT+
26 TOPS NPU: Vision & Deep Learning

• Arduino Mega 2560
Hard Real-Time Motor & Sensor Polling

• Power Distribution
12V/24V Regulated Power Rail & BMS

• Hardware Watchdog
Fail-Safe Heartbeat & Relay Dropper

3. UNDERSTAND
Perception & Fusion

3. AI PERCEPTION
“Understand Mine”

• 2D LiDAR SLAM
Real-Time 2D Grid Mapping (RTAB/Fast-LIO)

• Stereo Depth Fusion
Debris Clearance & Passage Traversability

• Thermal + RGB Fusion
Trapped Miner Detection in Dense Smoke

• Edge YOLOv8 Detection
Human Body & Posture Assessment

• Toxic Gas Heatmapping
Multi-Gas Thresholding & Hazard Zones

4. ASSESS
Risk & Governor

5. DECIDE
Autonomous Mission

4. RISK & GOVERNOR
“Assess Safety”

• Tunnel Hazard Index
Composite Score (Toxicity, Heat, Slopes)

• Drop-Off Proximity
Steep Slope & Water Hazard Avoidance

• Safety Governor
HARD CONSTRAINTS: Overrides AI Autonomy

• Emergency Rollback
Automatic Safe Retreat on Critical Gas

• Blackbox SD Buffer
Store-and-Forward Mission Flight Data

6. ACT
4WD Rugged Response

5. AUTONOMY & NAV
“Decide & Plan”

• Frontier Exploration
Autonomous Waypoints in Comms-Loss

• Risk-Aware A* / D*
Path Planning Avoiding High-Risk Pockets

• Bounded Autonomy
Time/Distance Limited Exploration Protocol

• Auto-Return Timer
Reverse Pathfinding to Signal Link

• Mission Scheduler
Energy & Battery Aware Navigation

7. RESCUE
Surface Dashboard

6. ROVER ACTUATION
“Act & Deploy”

• 4WD Rugged Chassis
High-Torque DC Geared Motors

• BTS7960 Drivers
Dual H-Bridge Motor Control Modules

• Pan-Tilt Gimbal
2-Axis Servo Camera Surveying Head

• Breadcrumb Deployer
Wireless Mesh Relay Dispenser Mechanism

• Emergency Beacons
High-Lumen Strobe & Acoustic Buzzer

SURFACE RESCUE TEAM DASHBOARD & SITUATIONAL AWARENESS (Base Station Station / Control UI)
🗺️ Live 2D Tunnel Grid Map & Hazard Heatmap | 📹 Low-Latency Video + Thermal Overlay Feed | 📡 Breadcrumb Mesh Signal & Telemetry Link | 🚨 Survivor Markers & Timestamped Mission Log | 🕹️ Manual Override & Emergency E-Stop Controls
Guiding Principle: “AI Assists Detection — Rescue Team Makes the Final Decision” | Bounded Autonomy During Signal Blackout
