sanjayforgit-oss/MINE_ROVER/(notices)

Notices in the files:
README.md:
License: MIT
